benkrasnow/DSKY_EL_replica/README.md

# DSKY_EL_replica
Schematic, PCB layout, mechanical CAD, and firmware to create a replica of the DSKY with electroluminescent display
https://www.youtube.com/watch?v=Z2o_Sp2-aBo
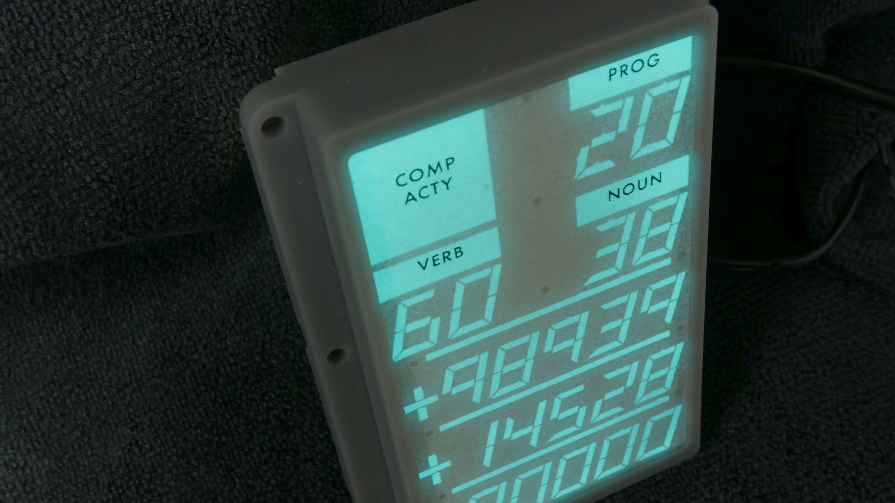
[picture p1: thumb.jpg]
Thumbnail image
