benkrasnow/DSKY_EL_replica/PCB - KiCad/DSKY_driver/DSKY_driver_sch2.pdf

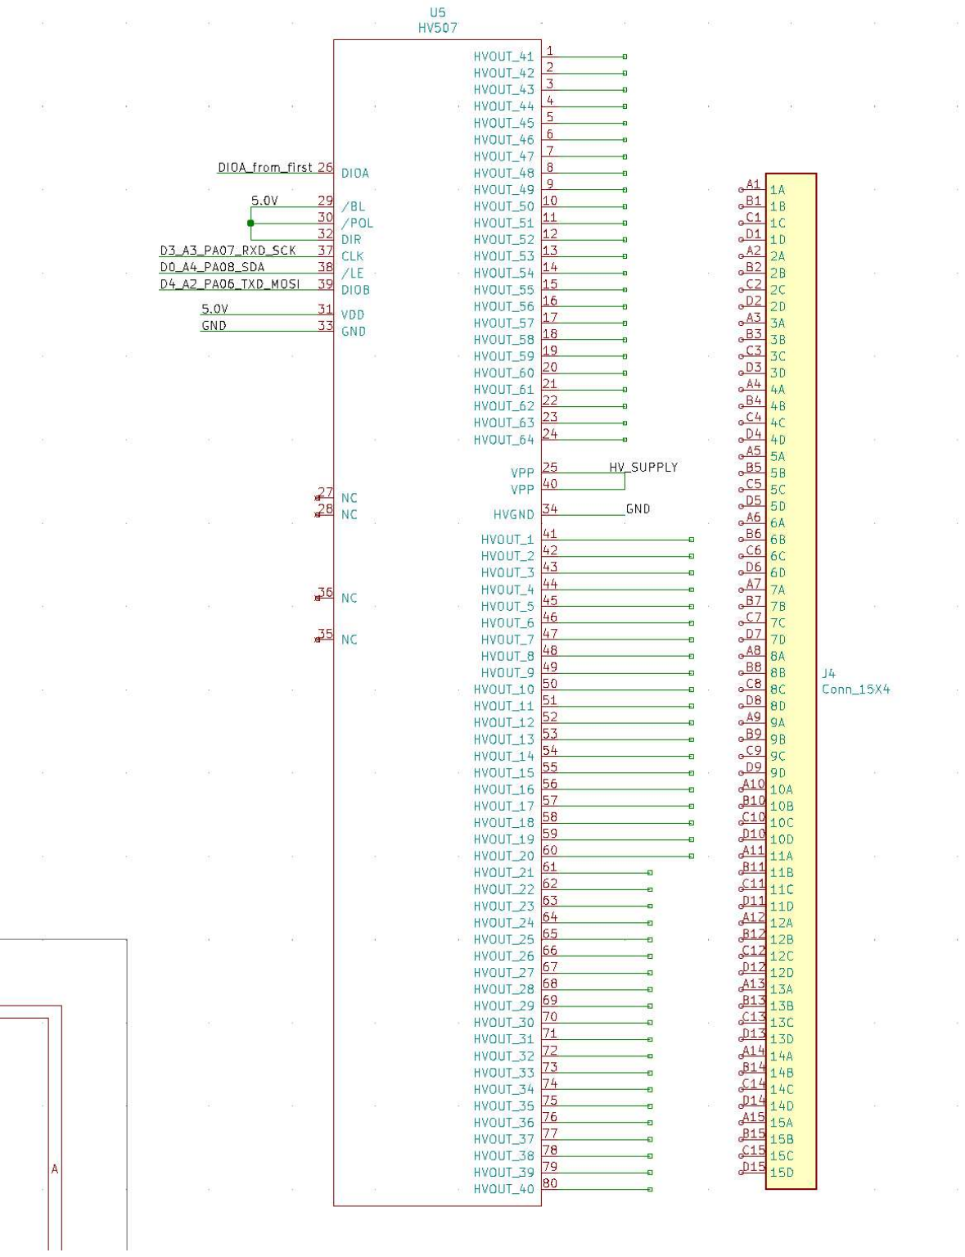
[picture p2: page 1]
