benkrasnow/DSKY_EL_replica/graphics/DSKY jpg.jpg

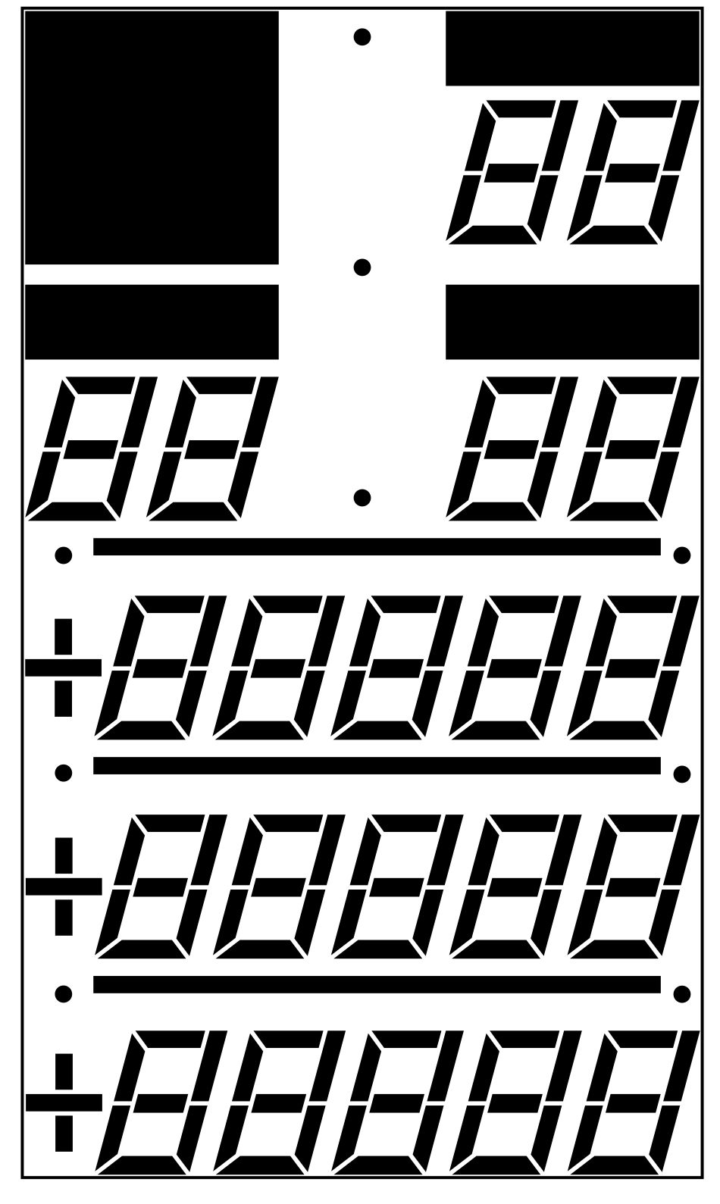
graphics/DSKY jpg.jpg
