benkrasnow/DSKY_EL_replica/graphics/screen mask.jpg

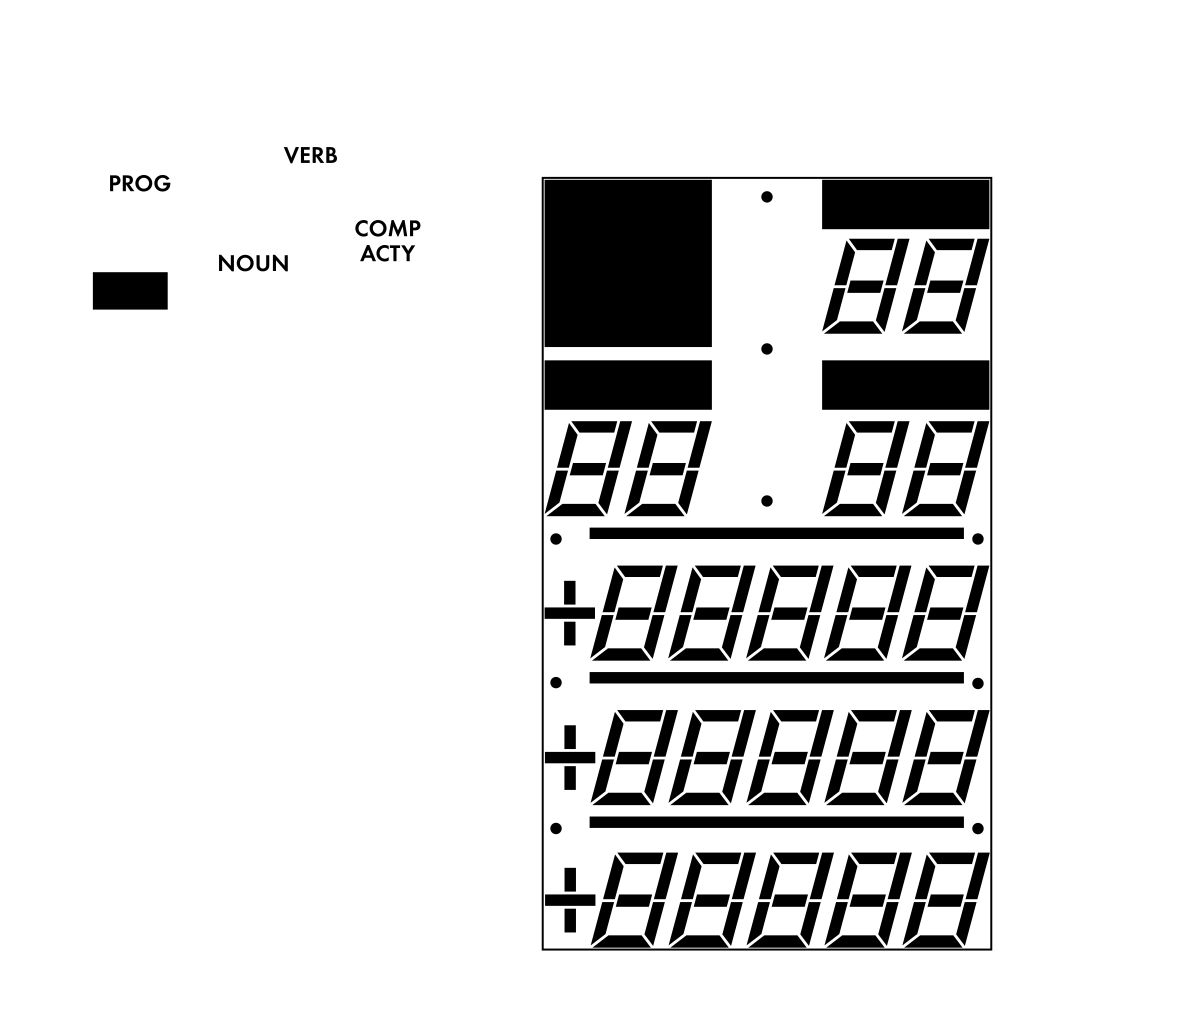
graphics/screen mask.jpg
