benkrasnow/DSKY_EL_replica/mechanical - Fusion360/DSKY_thumbnail.jpg

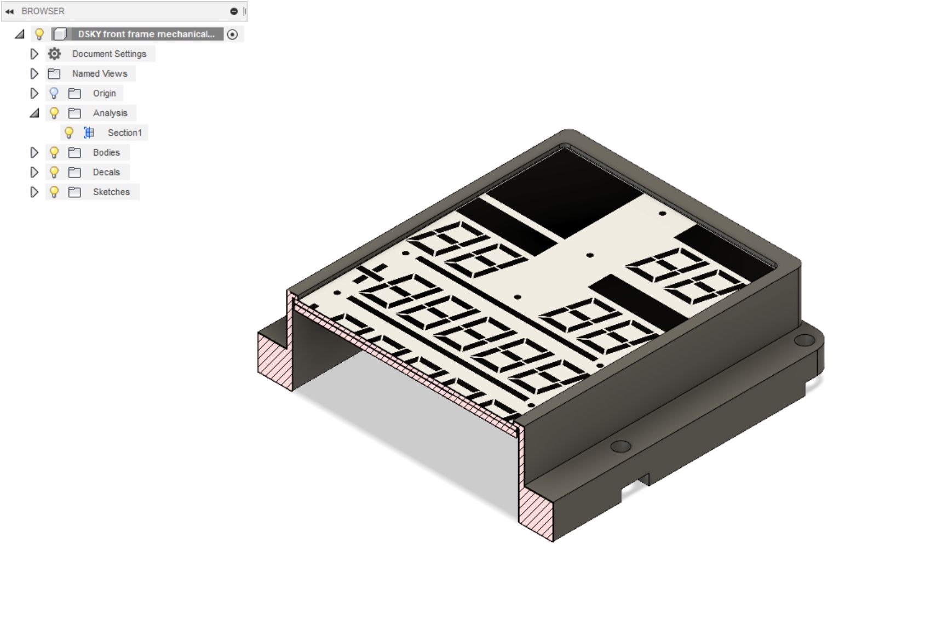
mechanical - Fusion360/DSKY_thumbnail.jpg
