benkrasnow/DSKY_EL_replica/mechanical - Fusion360/frame_with_retainer_cross_section.jpg

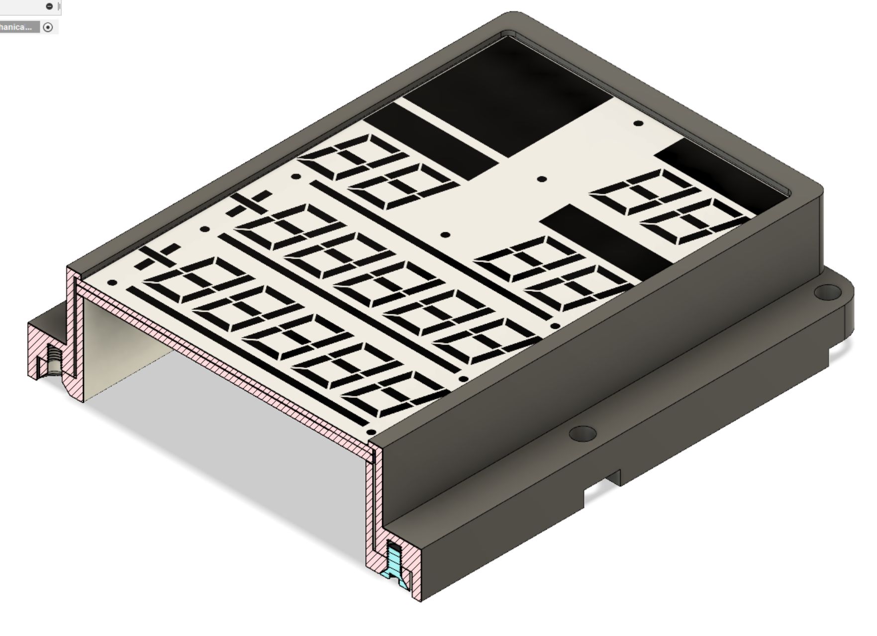
mechanical - Fusion360/frame_with_retainer_cross_section.jpg
