benkrasnow/DSKY_EL_replica/PCB - KiCad/Digikey_1.jpg

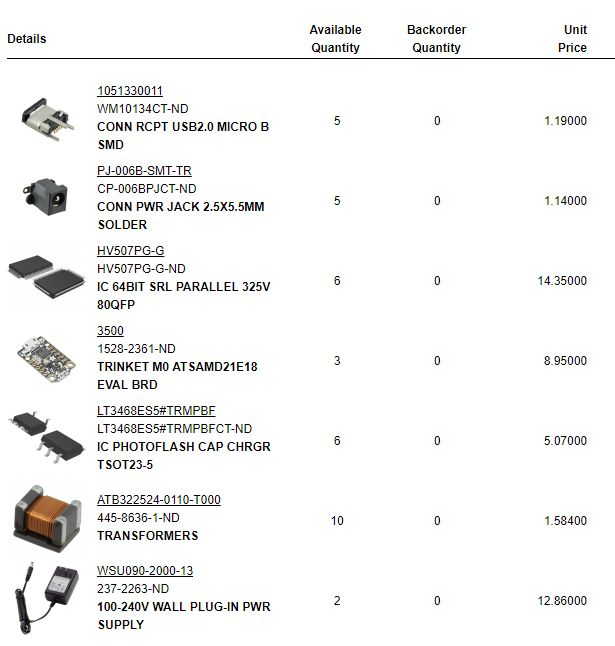
PCB - KiCad/Digikey_1.jpg
