benkrasnow/DSKY_EL_replica/PCB - KiCad/Digikey_2.jpg

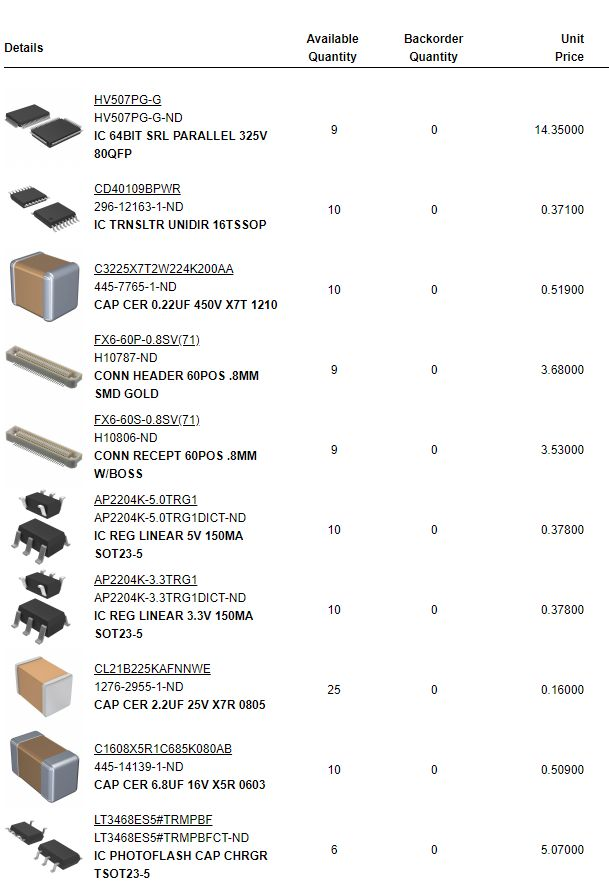
PCB - KiCad/Digikey_2.jpg
