benkrasnow/DSKY_EL_replica/PCB - KiCad/Digikey_3.jpg

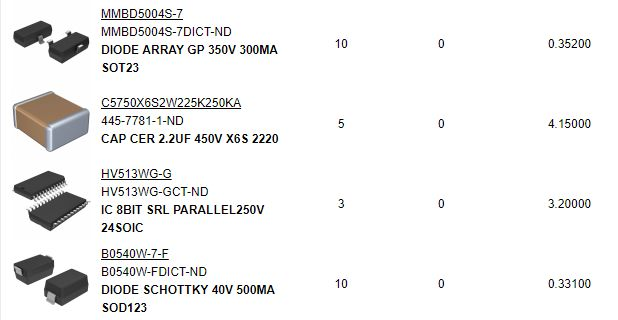
PCB - KiCad/Digikey_3.jpg
