benkrasnow/DSKY_EL_replica/PCB - KiCad/DSKY_segment/DSKY_seg.jpg

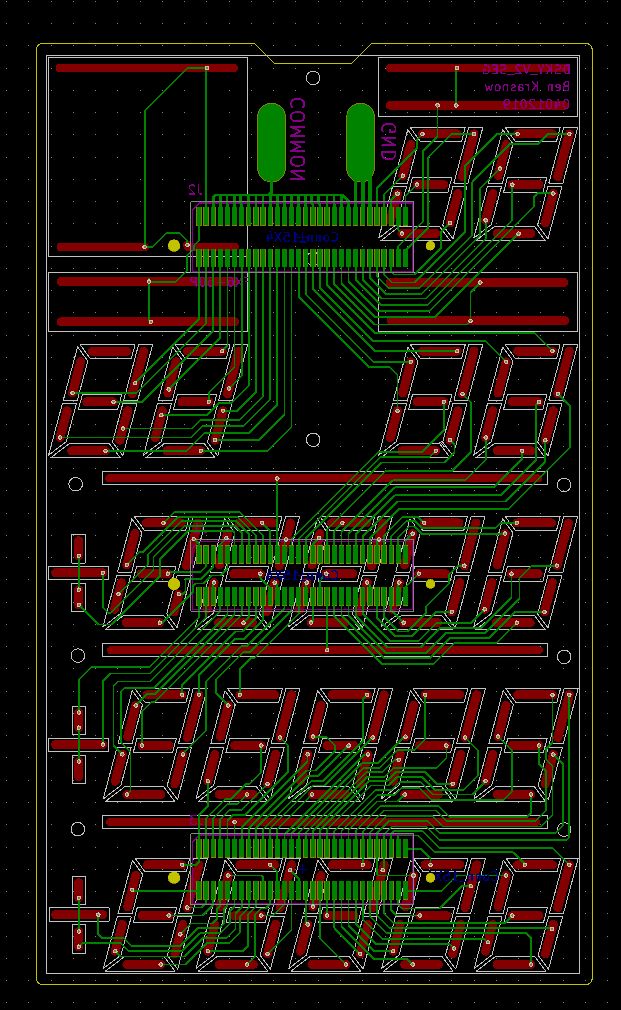
PCB - KiCad/DSKY_segment/DSKY_seg.jpg
