benkrasnow/DSKY_EL_replica/two DSKYs_2.1.1.jpg

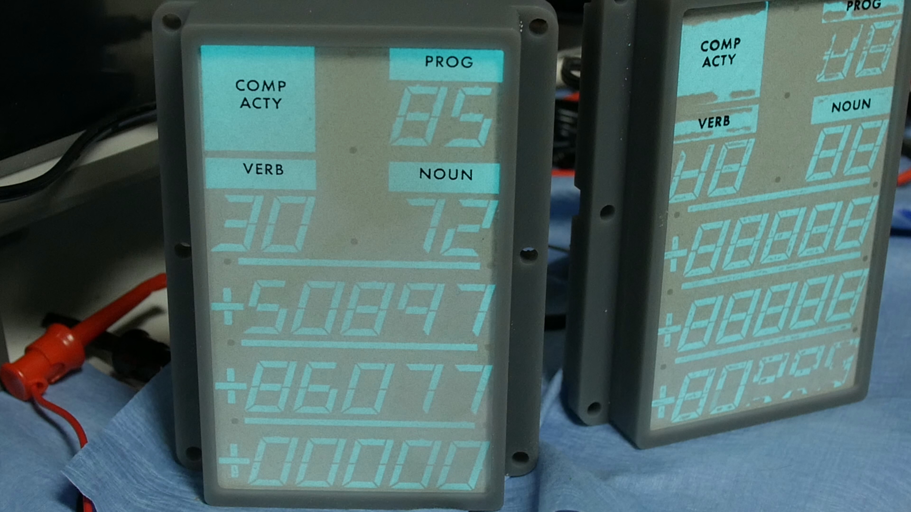
two DSKYs_2.1.1.jpg
