benkrasnow/DSKY_EL_replica/graphics/glass outline.dxf

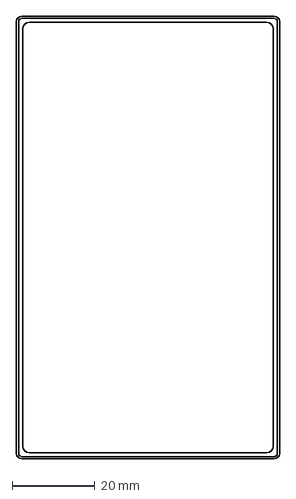
[picture p12: CAD file, 2019-04-13]
graphics/glass outline.dxf
63.5 x 106.8 mm
