benkrasnow/DSKY_EL_replica/mechanical - Fusion360/DSKY front frame mechanical with retainer.step

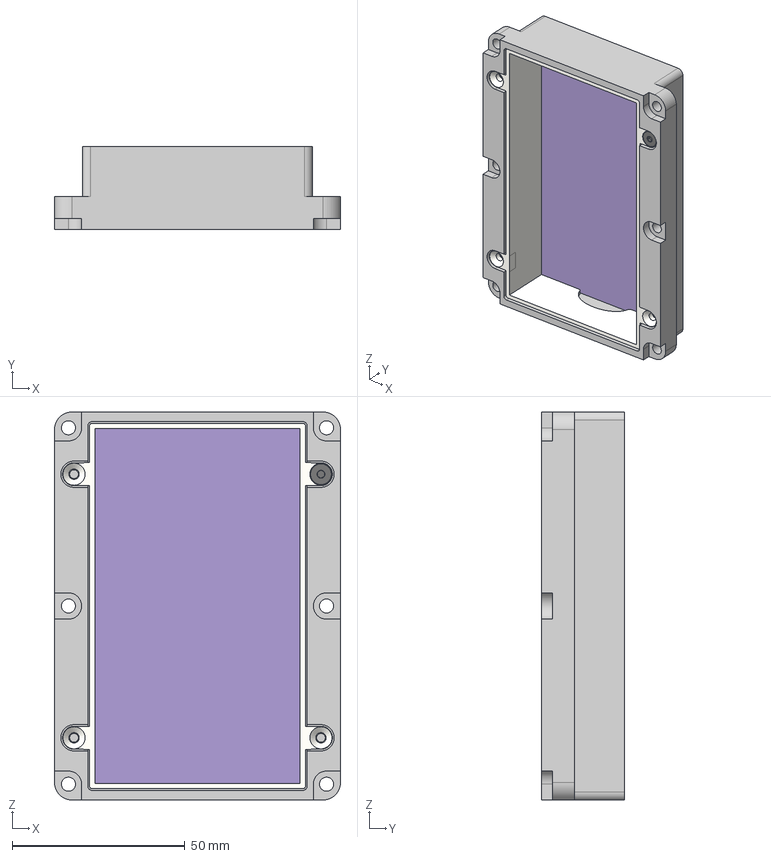
[picture p13: CAD file, 2019-04-13]
mechanical - Fusion360/DSKY front frame mechanical with retainer.step
82.8 x 23.9 x 112.3 mm
