benkrasnow/DSKY_EL_replica/graphics/DSKY_v2_face.dxf

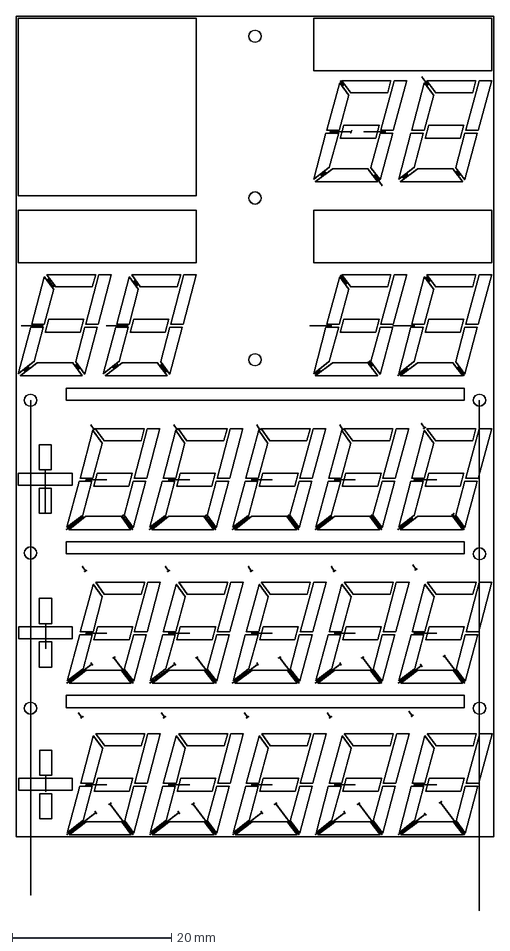
[picture p14: CAD file, 2019-04-13]
graphics/DSKY_v2_face.dxf
59.9 x 112.4 mm
