benkrasnow/DSKY_EL_replica/mechanical - Fusion360/retainer.stl

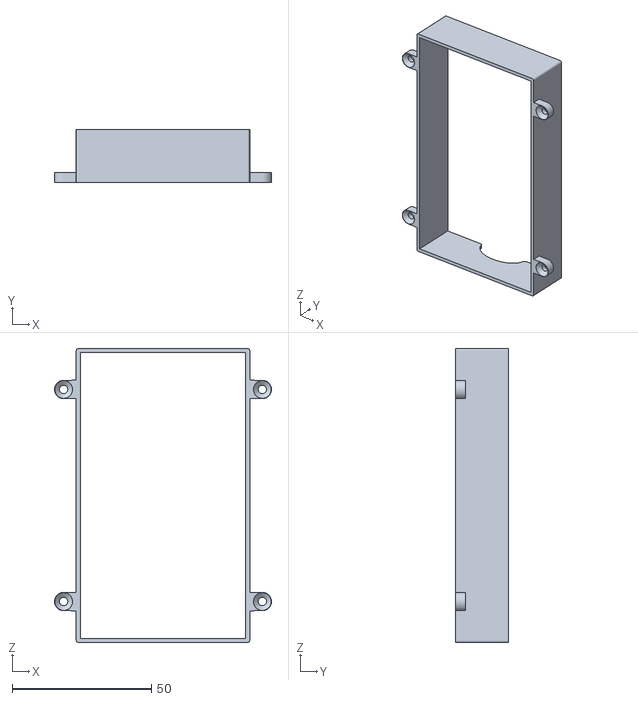
[picture p15: CAD file, 2019-04-13]
mechanical - Fusion360/retainer.stl
78.1 x 19.2 x 105.7
