benkrasnow/DSKY_EL_replica/mechanical - Fusion360/frame for retainer.stl

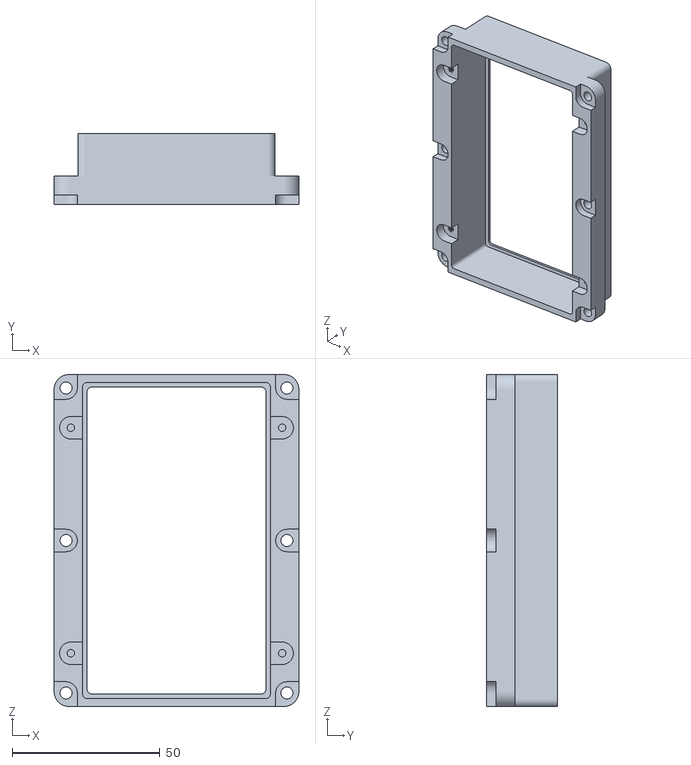
[picture p16: CAD file, 2019-04-13]
mechanical - Fusion360/frame for retainer.stl
82.8 x 23.9 x 112.3
