benkrasnow/DSKY_EL_replica/mechanical - Fusion360/DSKY frame.stl

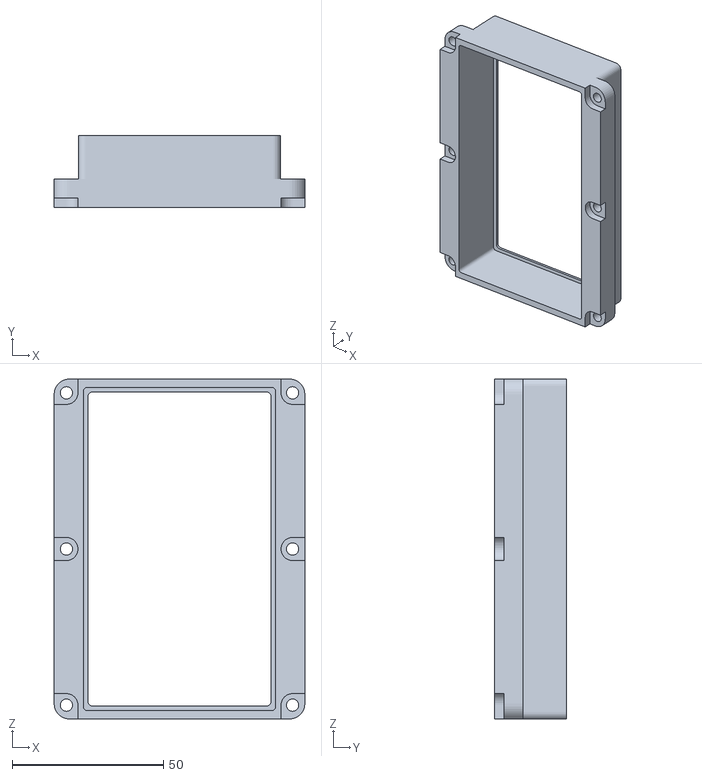
[picture p17: CAD file, 2019-04-07]
mechanical - Fusion360/DSKY frame.stl
82.8 x 23.9 x 112.3
