benkrasnow/DSKY_EL_replica/mechanical - Fusion360/DSKY front frame mechanical.step

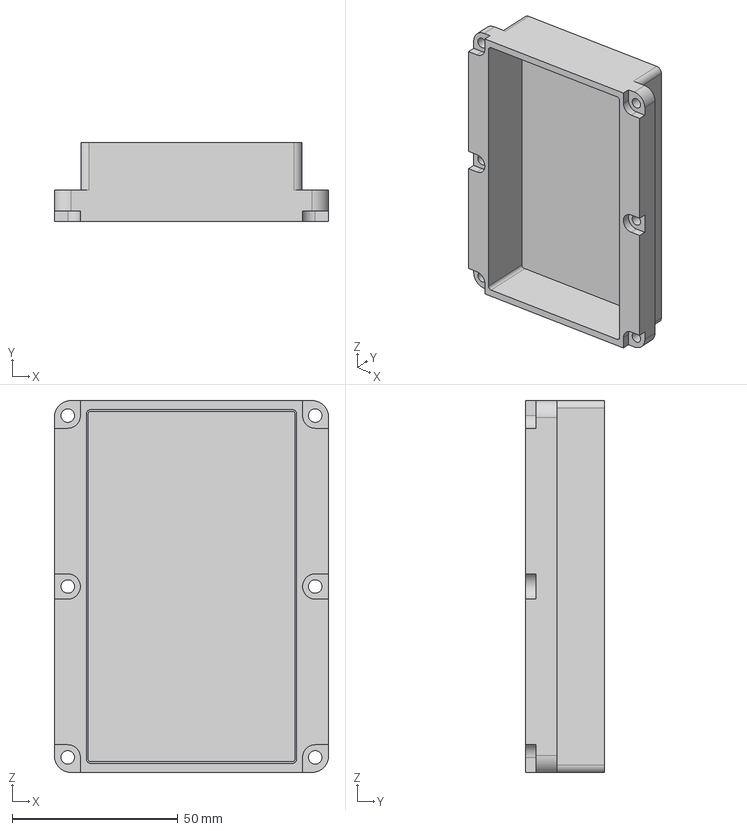
[picture p18: CAD file, 2019-04-07]
mechanical - Fusion360/DSKY front frame mechanical.step
82.8 x 23.9 x 112.3 mm
