benkrasnow/DSKY_EL_replica/(list of files, cad)

Other CAD files:
mechanical - Fusion360/DSKY front frame mechanical 3D.f3d
mechanical - Fusion360/DSKY front frame mechanical with retainer.f3d
mechanical - Fusion360/Segment display 2D.f3d
