benkrasnow/DSKY_EL_replica/(threads)

Thread 2 (2019-05-19):

BOM?

TAGood827, 2019-05-19:
Do you have a BOM for the PCBs?

benkrasnow, 2019-06-01:
Added BOM from Kicad default.  The file could use Digikey part numbers.  Want to add?

TAGood827, 2019-06-01:
Thanks, Ben! I had begun compiling a BOM which includes all the parts for both PCBs and P/Ns for Mouser. I had pulled that info from KiCAD but as it does not completely define the parts, I am only certain of a few components because only a limited number returned a specific enough part I was confident was correct. I have taken my best guess on them. I would ask you to review and if you find errors to please advise with more detail so I can correct and return to you.

I would also like to ask if it might be possible to contract you to manufacture just a few of the glass plates for me? I purchased a set of 10 boards from PCBGOGO to just do a few units for myself and a few close friends and I have purchased enough glass for 10 pieces. I would rather not invest in all the screen printing materials if I can avoid it as I am not looking to go into production. If you are local to the Philadelphia PA area, I would be open to meeting with you to discuss further.

This is a tremendous effort on your part and I cannot thank you enough for your extreme generosity in sharing this information with the Apollo DSKY fan community.

[Driver & Segment PCB BOMs.xlsx](https://github.com/benkrasnow/DSKY_EL_replica/files/3244254/Driver.Segment.PCB.BOMs.xlsx)

benkrasnow, 2019-06-02:
I added Digikey order lists (in .jpg) to the repo.  If you'd like to combine the part numbers, and add Mouser part numbers into the BOM, please submit it, and I'll be thankful and happy to add it.

I've been working non-stop on this project for a while, and want a rest to work on other things.  I don't have time to make 10 glass panels, but if there is enough interest, it may make sense to contract some work out, and maybe do some work in my shop.  I'll let you know.

TAGood827, 2019-06-02:
Thank you Ben! I'll update the BOM this afternoon and get it back to you.

TAGood827, 2019-06-02:
Okay, here's the integrated BOM with both Mouser and DigiKey P/Ns. I made a couple changes to the parts I had selected so there was full equivalency between Mouser and DigiKey. I had to change one of the caps as Digikey had no stock and a 54 week lead time. They listed several other equivalents and I chose the one that had a Mouser equivalent (Mouser doesn't stock the Samsung caps). Of the other items that you did not have an image for (those items in the list without a V in the Verified column) , I just crossed my choices from Mouser to find a DigiKey equivalent. Again I had to change a couple here and there but otherwise most of hem crossed directly.

There were a couple items shown in your images that I wasn't sure about. I could not match up their descriptions with anything in the KiCAD files. They are listed at the bottom of the spreadsheet.

I changed my ARM micro choice for just the chip since I was definitely wrong on that. There was an ATMEL ATMEGA programming tool that might have worked to program the chip onbard but It doesn't look like it is available anymore.

https://www.amazon.com/HobbyKing-Atmega-Socket-Firmware-Flashing/dp/B00V2W467I/

If I need to correct anything else please advise.

Thanks again for your assistance with this!

[Driver.Segment.PCB.BOMs.xlsx](https://github.com/benkrasnow/DSKY_EL_replica/files/3244983/Driver.Segment.PCB.BOMs.xlsx)

TAGood827, 2019-06-03:
Got my boards today, but it looks like they did not listen when I asked them to plate and mask on the bottom side of the display board only.

Do you think it is possible to remove the mask safely from the one side?

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

benkrasnow, 2019-06-04:
Probably the best way to salvage the board is to attach some 600 grit sandpaper with double-stick tape to a piece of glass, and then sand the solder mask down by hand until the segments are all visible.  This will probably work pretty well, and will leave you with a super flat surface for attaching to the painted glass display.  It's difficult to tell from the photos, but it looks like there might be solder on the exposed pads (HASL process?)  You'll pretty much always want to choose electroless nickel immersion gold (ENIG).  It makes soldering surface-mount parts much easier.  If you order more boards without mask, definitely choose ENIG for the segment boards.

The pushbutton, LEDs and their current-limiting resistors, and even caps can be lifted from the Adafruit Trinket board as well.

The unused parts on the Digikey were for other projects.

TAGood827, 2019-06-25:
Hello Ben,

I saw that you had your display hooked up to the AGC and the DSKY with Carl
Clauch! Congrats on that! Does that require different code to be loaded on
your display?

I also wanted to check in with you again about the EL DSKY glass. I have 9
other guys organized to build one of your displays using the boards I had
made. Before I order the parts from the BOM I worked out with you, I just
wanted to see where you stood regarding my request for you to contract
making the glass for me. I know you desired to take a break from the
project which I fully understand and again, I'm not asking you to do them
now. I would just like to know if you are willing to do them in the near
future. I would also like to ask if you could provide an estimate for your
services with me providing the glass I have to you. I would like to provide
this estimate to the rest of the guys to see if it would put them off doing
the build.

Thanks again for your efforts to produce this display and for sharing it
with all of us.

Tim

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

cjkeithley, 2019-07-03:
Hi Ben,

I was watching your video and noticed that you mentioned that you'd added some current limiting resistors to the HV509 outputs that drive common. But, I don't see these resistors on the driver or segment schematics... am I missing something or looking in the wrong place?

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

I'm interested as well!  I'd buy 2 or 3.

Thanks & best regards,

Craig

cjkeithley, 2019-07-03:
Make that HV507 (not HV509)

benkrasnow, 2019-07-04:
Tim, the firmware is the same.  Carl wanted to send data via physical serial port (not over USB), and luckily the SAMD21 can accommodate this for 19200 baud, which is fast enough to load the display at a fast frame rate.

I cannot commit to making a batch of glass panels, unfortunately.  Have you tried asking a traditional screen-print shop?  If you give them the artwork, and paints, they could likely do the job at higher quality and much faster than I could.

TAGood827, 2019-07-04:
Okay Ben, thanks for the info.

I haven't looked into any local shops yet. I'll have to start working on
that.

Thanks again!

Tim

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

TAGood827, 2019-07-04:
One other question, regarding the phosphor color. You had said it was a
little too blue. Is there a way to adjust that?

Tim

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

benkrasnow, 2019-07-07:
Lowering the drive frequency will shift the phosphor color to be more green, and less blue.  It will also make the display dimmer, so it seems 750Hz or thereabouts is a good compromise.  In earlier EL projects, I was driving at 4KHz.  I sent a note to Lumilor asking about greener colors, and they responded quickly and helpfully, but didn't have a way to supply any other colors.  I also briefly researched making a phosphor, and decided that was too much work.  I also haven't seen any color-corrected photos of a working DSKY, and have never seen one working myself, so it's hard to say exactly what it looked like despite the "530nm" specification on the official documents, which is indeed pretty deep green.

Closed 2019-06-01.

Thread 4 (2019-07-03):

Common current limiting resistors

cjkeithley, 2019-07-03:
Decided to open this as a new issue/question (rather than adding onto the closed BOM issue)

Hi Ben,

I was watching your video and noticed that you mentioned that you'd added some current limiting resistors to the HV507 outputs that drive common. But, I don't see these resistors on the driver or segment schematics... am I missing something or looking in the wrong place?

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

I'm interested as well! I'd buy 2 or 3.

Thanks & best regards,

Craig

benkrasnow, 2019-07-04:
You are correct:  I used current-limiting resistors to join together the HV507 outputs, but they are not listed on the schematic.  This change was made after the last revision (ie I haven't actually changed the CAD, even on my local copy.  I just cut the traces and soldered resistors in there.)  I was using values of about 47Kohm.

Closed 2019-07-07.

Thread 5 (2019-07-07):

Airbrushing the Lumilor paint

cjkeithley, 2019-07-07:
Hi Ben,

Since mid last year I've been contemplating using the Lumilor paint to create a DSKY EL digital indicator, so I was pleased to see your project was a success.  I hesitated because Lumilor says you need to use an HVLP gun with their paint.

I don't know enough about airbrushing to have an opinion on using an HVLP gun, but I was startled to discover that most HVLP guns require 5+ CFM, and that even my middling air compressor puts out less than 2CFM... and that compressors that can put out 5+ CFM can be expensive.  Sadly, Amazon doesn't specify the CFM required by the PowRyte guns.

Where am I'm going with this?

A question:  did you use a high (5+) CFM compressor with that small PowRyte HVLP gun, or did you use a standard work shop (or air brush) compressor (<2 CFM)?

If you used a <2 CFM compressor with the small PowRyte gun then my existing compressor should suffice as well.  If needed to use a high CFM compressor with the PowRyte then I'll likely trying using a Paasche HG-08, which (best case) only requires 1.5 CFM.

Thanks,

Craig

benkrasnow, 2019-07-07:
I've used https://www.amazon.com/gp/product/B004INERK4/ and https://www.amazon.com/gp/product/B01G61DNF0/ to spray Lumilor with an average sized 110V shop air compressor (not sure of CFM, but manufacturers all exaggerate so much, it doesn't matter).  It works fine since you'll only need high air flow from the tank for short bursts while painting, and the compressor can keep up in between.  Unless you are painting a whole car, the compressor tank will be able to supply as much air as you need for small objects.

cjkeithley, 2019-07-07:
great advice, thanks!

Closed 2019-07-07.

Thread 6 (2020-07-06):

VBUS signal line on X1 USB connector

rrainey, 2020-07-06:
Ben, do you ever use the USB interface on the Driver board? I'm noticing that VBUS (pin1) on X1 doesn't seem to be tied to anything. That's a bit different than the Trinket M0 where the core design seems to be derived from.

I'm guessing that means that you'd first power up the board using the power plug before connecting the USB. Just curious.

benkrasnow, 2020-07-06:
The design requires more power (and voltage, if I recall) than USB can deliver.  So, I made the choice to only power the device from the external supply.  You could power up the MCU via USB, but then nothing else on the device would work, so that doesn't make sense from a usability standpoint.

rrainey, 2020-07-06:
Thanks, that all makes sense. Does that mean you are not using the USB for any purpose at all, or simply that you are taking power from the power plug but will still occasionally hook up the USB for talking to the MCU?

benkrasnow, 2020-07-06:
USB is how the MCU is programmed, and the only way that data are sent to the display in operation, so yes, it is used.

rrainey, 2020-07-06:
I'm asking as I look ahead to the development/test/debug required to integrate a display board into a larger DSKY replica of my own design.  If I need to resort to SWD/SWC prgramming, I can -- just wondering what to expect might work ...

rrainey, 2020-07-06:
Got it. Thanks

Closed 2020-07-06.

Thread 7 (2020-07-06):

HV507 Common line: diode protection and current limiting

rrainey, 2020-07-06:
Hi Ben,

I was looking at the last committed Segment PCB layout in GitHub and comparing that with your YouTube walk-through video.

I see what looks like the Common protection diodes you mentioned at the end of your video already on the Segment PCB (1)-- I see sixteen parallel Common lines rather than the eight you mentioned in the video, though (2).

I'm guessing you made a late change in the number of Common driver lines subsequent to producing the walk through video -- correct?

I'm guessing we'd still put one current limiting resistor on each Common driver line (you mentioned a value of 47K Ohms elsewhere) -- if all that is correct, I might just put together an updated board layout and get a fresh batch of Segment boards made.

Your thoughts?

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

benkrasnow, 2020-07-06:
If I were going to redesign it, I'd add a current-limiting resistor to each line immediately at the IC's output.  Then, downstream of the current limiting resistors, 8 or 16 lines could be joined together for better drive strength.  I would not build it as shown in #2, since even if all lines are switched exactly at the same time, mismatch in output transistors causes problems (ie the IC is destroyed).  The clamp diode is good insurance, so I'd keep all that as-is.

rrainey, 2020-07-06:
Well, I'm not sure I have the stomach that scale of a redesign at this point -- the driver PCB is really packed (at least for my skill level). Some substantial layout changes would be required to add the resistors next to the chip as you suggest. Am I quoting the right value for the resistors - 47K?
I was going to use 0.2W resistors (the HV507 data sheet rates the output of each line at 0.5mA).
Thanks for your support!

benkrasnow, 2020-07-06:
You can add the resistors to the segment board -- same step as placing and reflowing the board-to-board connectors.  I think you'll definitely want to add resistors to at least the 8 or 16 common lines -- don't connect them directly together as shown.  It may work for a while, but it's probably not a good plan.  Ideally, the resistors would be added to every segment, but it's likely that it will work fine only putting resistors on the commons only.  The resistors will dissipate very little average current, so 0402 or even 0201 would be fine.  Don't worry about the power rating.  47K minimum.  Maybe even go 100K.  I'm sorry for the lack of precision in my design -- it's not a problem of missing documentation, but rather a lack of having a completely final ready-for-production design.  There are still some small tweaks needed.

rrainey, 2020-07-06:
Thanks! will do.

rrainey, 2020-07-07:
I played with adding resistors to the Segment board in KiCad (image below). Having overnight to ruminate about this, though, I think I've decided to try placing the limiting resistors on the driver board as you suggested. The design already requires components on both sides of the board -- having the resistors on the connector side doesn't fundamentally complicate anything.

I'm having a few issues bringing up these projects for editing in KiCad. As is, it was complete enough that I could send the KiCad files to CircuitHub for production. I might need some pointers getting the Driver board project editable. I'll keep you posted.

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

rrainey, 2020-07-07:
I toyed with adding resistors to the Segment board last night (image below).

I'm going to think more about your suggestion to place them on the Driver board instead. I'll try to commit to a choice this week.

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

Closed 2020-07-07.

Thread 8 (2020-07-07):

Current limiting resistor array modification

rrainey, 2020-07-07:
I worked this change up last night.  Sixteen 0402 75K (or 100K) resistors.
CircuitHub will make a batch of 10 unpopulated boards for about $220 and 20 for only $20 more.  Want any?

I can send you a pull request with the modifications.

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

benkrasnow, 2020-07-12:
Sure send a pull request for the resistors.  I haven't worked on the DSKY in quite a while, so don't have a need for PCBs.  I think you'll find a lot of folks that want to buy them, though!

rrainey, 2020-07-13:
Great. I just submitted the pull request. I'll close this Issue.

Closed 2020-07-15.

Thread 10 (2020-11-22):

Serial USB interface testing

rrainey, 2020-11-22:
I was wondering what hardware you run the https://github.com/benkrasnow/DSKY_EL_replica/blob/master/software%20-%20Processing.org/DSKY_serial_control_tester/DSKY_serial_control_tester.pde Arduino program.  You ran that on a Windows PC connecting to the Driver board with a USB A-to-microB cable, correct?

benkrasnow, 2020-11-22:
Yup. Processing.org on a Windows PC, with a USB cable to the PCB.  Serial port connection over USB.

rrainey, 2020-11-23:
Thanks for the info.

Thread 11 (2020-12-07):

KiCad Driver Project SCH file does not include HV507 to connector wires

rrainey, 2020-12-07:
I am working on adding current limiting resistors as we discussed and I'm just looking at the Driver schematic. There don't seem to be connecting wires between the HV507 output lines and the connectors. Was that an oversight in the SCH file that was committed or did you route each of those manually on the PCB design?

benkrasnow, 2020-12-07:
Looks like I just connected them in the PCB design since the layout would dictate the best connection scheme.

rrainey, 2020-12-08:
NP. With the placement of the HV507s relative to the connectors, I think I might "punt" and place the resistors on the segment board. I'm working on that now.

Closed 2020-12-08.

Thread 12 (2020-12-08):

Not an issue; Just an interesting reference on EL current limit resistor selection.

rrainey, 2020-12-08:
In doing some research on selecting an "optimal" value for current limiting resistors in EL Display Driver design, I came across this reference: https://patents.google.com/patent/US5095248

I suspect this might be applicable here -- any thoughts?

benkrasnow, 2020-12-10:
I gave it a quick read, and don't immediately see anything applicable.  Can you be more specific?

rrainey, 2020-12-10:
There was a relation buried in there regarding a guideline for selection of current limiting resistor values. I realize the overall design of their driver is a bit different, but I was wondering if it might be applicable.  I know we talked about using 100k or 75k resistors, but I was just wondering if there was a more deliberate way to make a selection.

You'd have to examine the patent document to get the meanings of variables, but this was the relation to be enforced:

Va - (VD (on) + ID (on) × Ri) ≧ 2 (VTEL + VMOD)

benkrasnow, 2020-12-11:
It looks like the patent is describing an active matrix driver circuit for EL display elements.  The design constraints are different since the bipolar AC waveform is being supplied from an external source, and the resistor is used to prevent the tiny pixel-level driver from passing too much current when the pixel is illuminated constantly.  The HV507 circuit in this project starts with a unipolar high voltage supply and fakes this into a bipolar supply by switching both sides of the EL element, which is where the trouble begins .  Switching both sides of the element (as opposed to just switching on/off an existing AC waveform) creates a much bigger possibility for overshoot, which is what happens when the clamp diodes in the HV507 get overwhelmed.  The current limiting resistors protect the clamp diodes, which then protect the rest of the IC.  It's not a constant power dissipation problem.

rrainey, 2020-12-12:
Thanks. Got it.  BY the way, I was looking at alternatives for adding all the requisite resistors.  One goal -- for me at least -- is to avoid making huge changes to your original implementation. Arrays seem relatively expensive and also take up quite a lot of PCB real estate (at least when you get 14 or so 12-way arrays placed). I even considered adding a third board to sandwich in between the Segment and Driver boards where the resistors would be placed -- that has the virtue of being insert-able into the assembly without altering the original two boards.  I have not completely abandoned that idea, but for now I am just adding the 161 new discrete resistors to the Segment board.

I started by cataloging the three connector connection list (attached)
[Display J pinouts - Sheet1 - Display J pinouts - Sheet1.pdf](https://github.com/benkrasnow/DSKY_EL_replica/files/5682160/Display.J.pinouts.-.Sheet1.-.Display.J.pinouts.-.Sheet1.pdf)

Closed 2020-12-13.
