benkrasnow/DSKY_EL_replica/PCB - KiCad/DSKY_driver/DSKY_driver_sch1.pdf

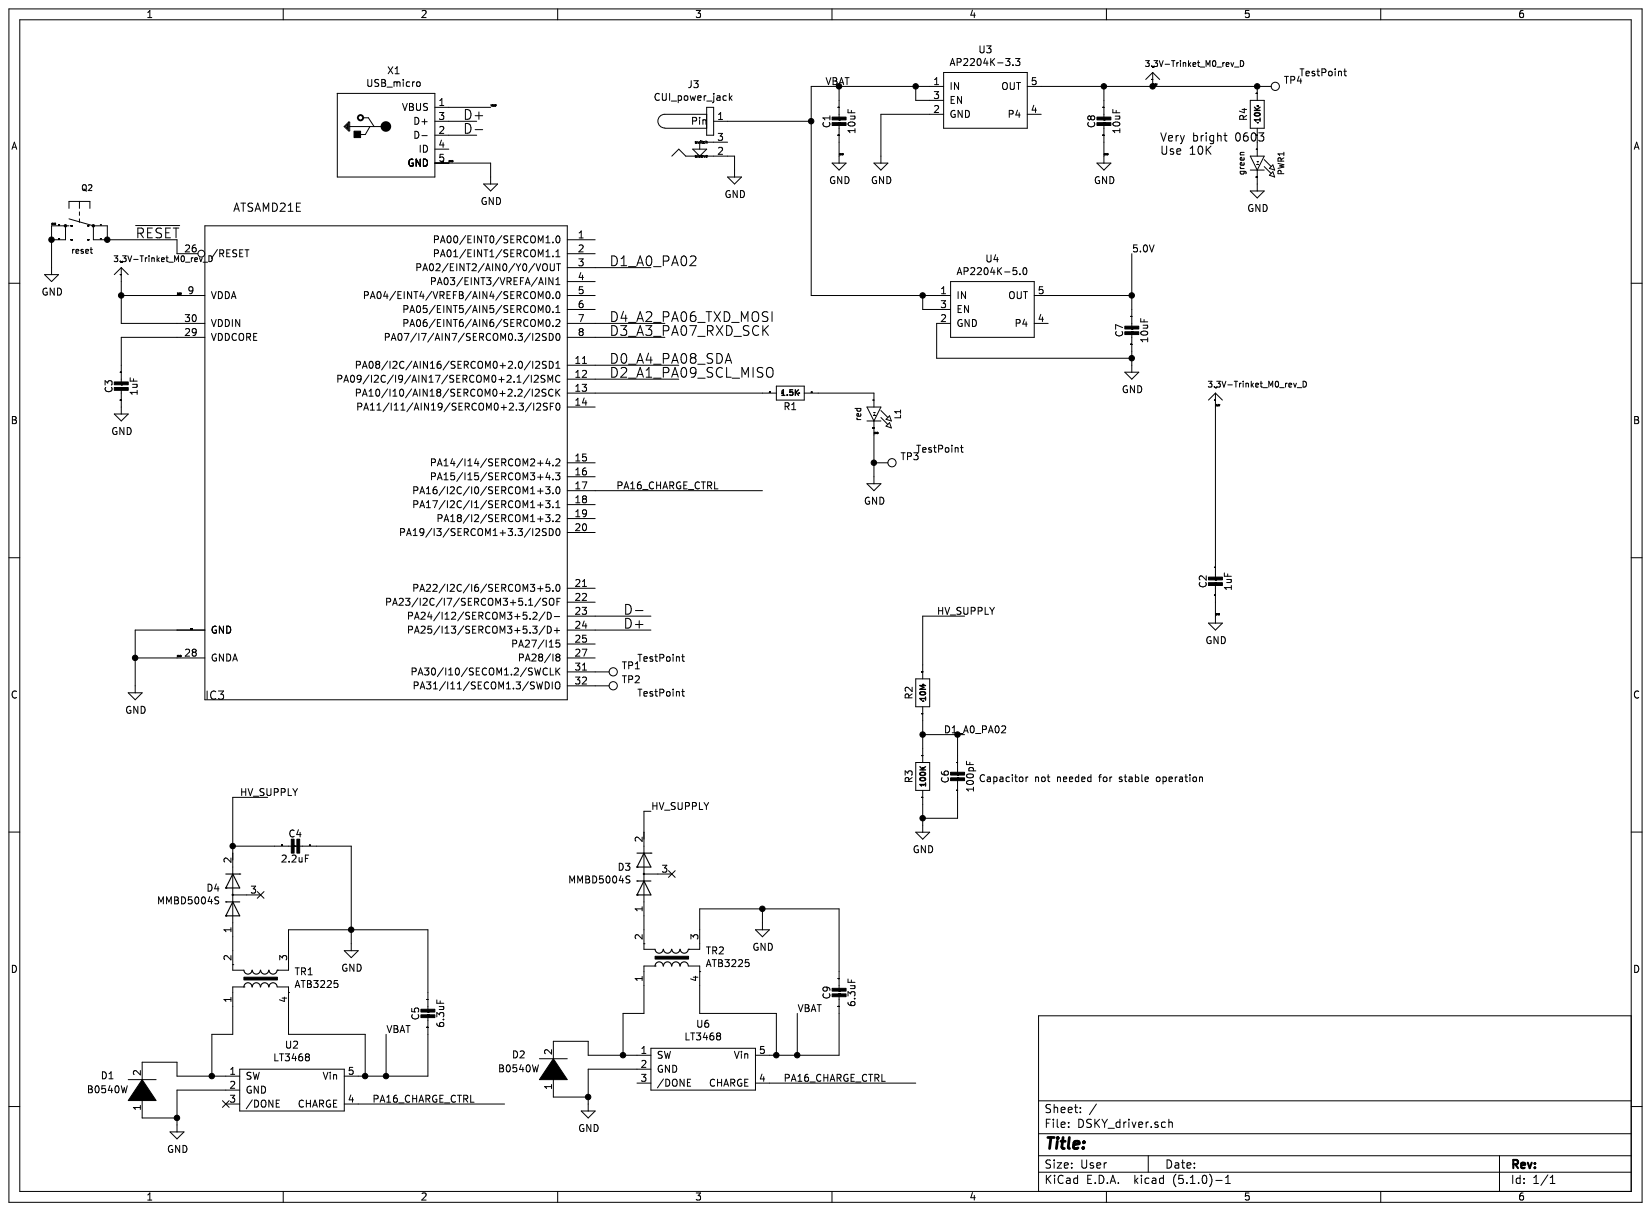
[picture p19: page 1]
