benkrasnow/DSKY_EL_replica/(commit log)

2019-04-07 Added DSKY driver PCB
    [DSKY_driver.kicad_pcb, DSKY_driver.sch]
2019-04-07 Added DSKY segment PCB
    [DSKY_segment.kicad_pcb, DSKY_segment.sch]
2019-04-07 Added mechanical CAD
    [DSKY front frame mechanical 3D.f3d, Segment display 2D.f3d]
2019-04-07 Added mechanical step, stl and Formlabs print file
    [DSKY frame.stl, DSKY front frame mechanical.step]
2019-04-13 Added vector layout graphics
    [DSKY V2.dxf, DSKY_v2_face.dxf, glass outline.dxf]
2019-04-13 Added version of frame with retainer to hold glass/PCB
    [DSKY front frame mechanical with retainer.f3d, DSKY front frame mechanical with retainer.step, frame for retainer.stl, retainer.stl]
2019-04-16 Added .form Formlabs print files
2019-04-16 Modified layout to support common electrode
    [DSKY_segment.kicad_pcb]
2019-04-16 Shrink PCB outline
    [DSKY_driver.kicad_pcb]
2019-04-16 Added display stackup materials and sources
2019-04-16 Added screen print supplies
2019-04-22 V3 of PCB hardware
    3.3 to 5V level shifter added
    Added decoupling caps to 5V rail and HV rail
    Added cap to RESET line
    Fixed locating holes in FX6 footprint
    Fixed unintentional trace overlap
    Eliminated the "GND" feature, and re-assigned all lines to be the common electrode
    Fixed a routing error on the segment PCB, and re-assigned one common electrode line to be a segment line.
    The above changes mean that the common electrode mask in firmware *must* be updated.
    [DSKY_driver.kicad_pcb, DSKY_driver.sch, DSKY_segment.kicad_pcb, DSKY_segment.sch]
2019-05-06 V4 of segment PCB
    Routing fixes. Added protection diode for common electrode
    [DSKY_segment.kicad_pcb, DSKY_segment.sch]
2019-05-28 Added hardware serial port functionality
    Variant.cpp must be installed in Users\[user]\AppData\Local\Arduino15\packages\adafruit\hardware\samd\1.2.3\variants\trinket_m0 to make use of pins that are not wired on the original Adafruit Trinket M0.
2019-06-01 Added BOM
    I didn't add digikey part numbers. Someone willing to fill it out?
    [DSKY_driver.csv]
2019-06-04 Added BOM with Mouser and Digikey PNs (from TAGood827)
    [Driver.Segment.PCB.BOM.xlsx]
2020-07-07 Add 0402 size current limiting resistors. Update PCB markings
    [DSKY_segment.kicad_pcb, DSKY_segment.sch]
2020-07-14 Switch to project-relative pathname in DSKY_driver footprint library reference
